Oteken/Stahpwatch/README.md

# Stahpwatch
Files for the stahpwatch object
