Oteken/Stahpwatch/3D printing/Clock Hand Junction + Clock Hand.stl

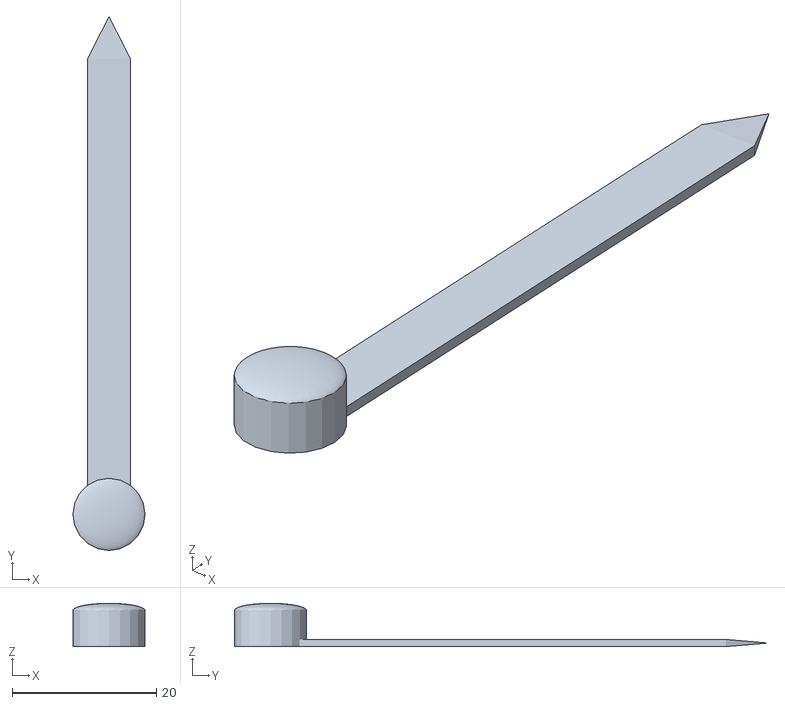
[picture p14: CAD file, 2017-11-02]
3D printing/Clock Hand Junction + Clock Hand.stl
10.0 x 74.0 x 6.00
