Oteken/Stahpwatch/3D printing/Clock Hand Junction 2.stl

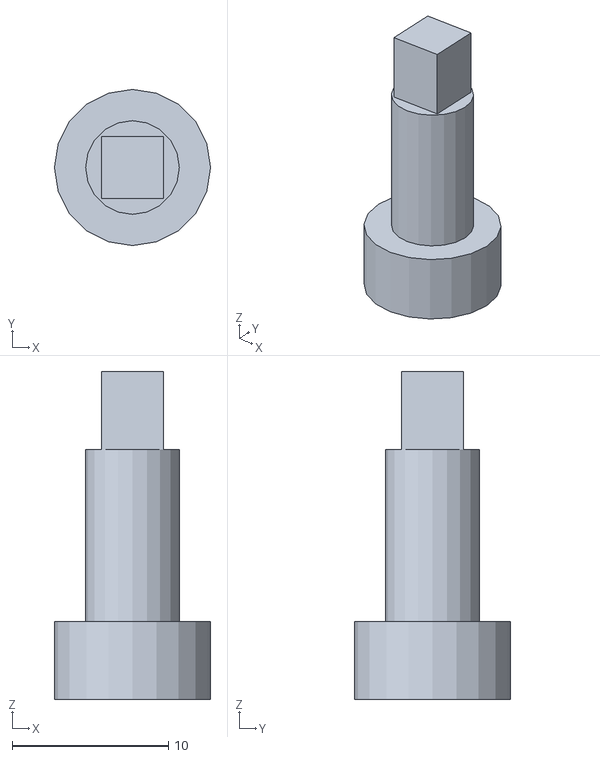
[picture p15: CAD file, 2017-11-02]
3D printing/Clock Hand Junction 2.stl
10.0 x 10.0 x 21.0
