Oteken/Stahpwatch/3D printing/Stepper Junction.stl

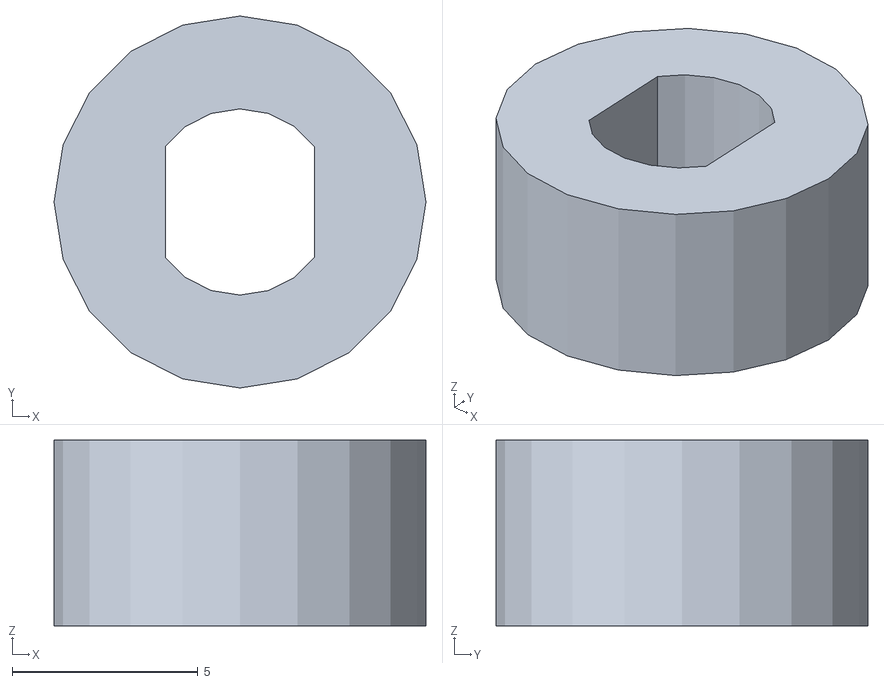
[picture p16: CAD file, 2017-11-02]
3D printing/Stepper Junction.stl
10.0 x 10.0 x 5.00
