Oteken/Stahpwatch/(list of files, drawings)

Other design files:
Fritzing/ElectricSchema.fzz
