Oteken/Stahpwatch/(commit log)

2017-11-02 Initial files
    [Clock Hand Junction + Clock Hand.stl, Clock Hand Junction 2.stl, Stepper Junction.stl]
2017-11-02 Motor working now, displacing 1 digit every minute.
2017-11-02 Lighting effects now also working correctly. Currently has two modes where light keeps track of seconds, and clock hand can keep track of seconds and minutes.
    [Stahpwatch.ino]
2017-11-02 Added button. pressing button will reset timer to original position, and reset leds. Holding button will move the clock hand until released.
    [Stahpwatch.ino]
2017-11-03 Added different top side for arduino case. Also added an engraved version of the wooden clock face.
2017-11-03 Added shutdown function. Clock now shuts down when button is pressed. The next press starts the clock again. Also added electronics schematics.
    [ElectricSchema.fzz]
